AlSaqr-platform/he-soc/hardware/regressions/regression.csv

0 | ../software/iommu/iommu_test_01_04.elf | none | none |  | 0
0 | ../software/iommu/iommu_test_05.elf | none | none |  | 0
0 | ../software/iommu/iommu_test_06_10.elf | none | none |  | 0
0 | ../software/iommu/iommu_test_11_12.elf | none | none |  | 0
0 | ../software/snooper_test | opentitan/sw/tests/alsaqr/snooper_test/snooper_test_instr.elf | none |  | 0
0 | ../software/snooper_test | opentitan/sw/tests/alsaqr/snooper_test/snooper_test_addr.elf | none |  | 0
0 | ../software/snooper_test | opentitan/sw/tests/cluster/addressability/addressability.elf | none |  | 0
0 | ../software/peripherals/qspim_flash | none | none |  | 0
0 | ../software/peripherals/spim_flash | none | none |  | 0
0 | ../software/peripherals/uart | none | none |  | 0
0 | ../software/peripherals/usart | none | none |  | 0
0 | ../software/peripherals/sdio | none | none |  | 0
0 | ../software/peripherals/cam | none | none |  | 0
0 | ../software/peripherals/ethernet | none | none |  | 0
0 | ../software/can | none | none |  | 0
0 | ../software/hyperbus | none | none |  | 0
0 | ../software/l2_test_restricted | none | none |  | 0
0 | ../software/l3_test_4cs_2phy | none | none |  | 0
0 | ../software/llc_spm_test | none | none |  | 0
0 | ../software/hello_culsans | none | none |  | 0
0 | ../software/bypass_cva6_dco | none | none |  | 0
0 | ../software/pmu_IOPMP_L2RW_test | none | none |  | 0
0 | ../software/pmu_L3_test_v2 | none | none |  | 0
0 | ../software/pmu_test | none | none |  | 0
0 | ../software/monitor_counter | none | none |  | 0
0 | ../software/htm | none | none |  | 0
0 | ../software/mbox_test | opentitan/sw/tests/alsaqr/mbox_test/mbox_test.elf | none |  | 0
0 | ../software/hello_culsans | opentitan/sw/tests/opentitan/idma_test_advanced/bazel-out/idma_test.elf | none | 1 | 0
0 | ../software/hello_culsans | opentitan/sw/tests/cluster/mbox_test/mbox_test.elf | none | 1 | 0
0 | ../software/hello_culsans | opentitan/sw/tests/cluster/par_matmul_fp32/par_matmul_fp32.elf | none | 1 | 0
0 | ../software/hello_culsans | opentitan/sw/tests/opentitan/monitor_counter/bazel-out/monitor_counter.elf | none | 1 | 0
1 | ../software/hello_culsans | none | none | 1 | 0
