AlSaqr-platform/he-soc/hardware/regressions/regression_netlist.csv

0 | ../software/hello_culsans | none | none |  | 0
0 | ../software/hyperbus | none | none |  | 0
0 | ../software/l2_test_restricted | none | none |  | 0
0 | ../software/l3_test_4cs | none | none |  | 0
0 | ../software/llc_spm_test | none | none |  | 0
0 | ../software/mbox_test | opentitan/sw/tests/alsaqr/mbox_test/mbox_test.elf | none |  | 0
0 | ../software/hello_culsans | opentitan/sw/tests/cluster/mbox_test/mbox_test.elf | none | 1 | 0
0 | ../software/snooper_test | opentitan/sw/tests/cluster/addressability/addressability.elf | none |  | 0
0 | ../software/iommu/iommu_test_05.elf | none | none |  | 0
0 | ../software/hello_culsans | opentitan/sw/tests/opentitan/idma_test/idma_test.elf | none | 1 | 0
0 | ../software/hello_culsans | opentitan/sw/tests/cluster/par_matmul_fp32/par_matmul_fp32.elf | none | 1 | 0
