AlSaqr-platform/he-soc/software/gpios/gpios.c

/*
 * Copyright (C) 2021 ETH Zurich and University of Bologna
 *
 * Licensed under the Apache License, Version 2.0 (the "License");
 * you may not use this file except in compliance with the License.
 * You may obtain a copy of the License at
 *
 *     http://www.apache.org/licenses/LICENSE-2.0
 *
 * Unless required by applicable law or agreed to in writing, software
 * distributed under the License is distributed on an "AS IS" BASIS,
 * WITHOUT WARRANTIES OR CONDITIONS OF ANY KIND, either express or implied.
 * See the License for the specific language governing permissions and
 * limitations under the License.
 */

/*
 * Mantainer: Victor Isachi (victor.isachi@unibo.it)
 */

#include <stdio.h>
#include <stdint.h>
#include "utils.h"
#include "gpio_v3.h"
#include "udma.h"

#define BUFFER_SIZE 32

#define ARCHI_GPIO_ADDR 0x1A105000
#define CSR_MTOPEI 0x35C

#define OUT 1
#define IN  0

// #define FPGA_EMULATION
// #define SIMPLE_PAD

#ifndef FPGA_EMULATION
  #ifndef SIMPLE_PAD
    #define NUM_GPIOS_A 30
    #define NUM_GPIOS_B 48
    #define NUM_REPS 2
  #else
    #define NUM_GPIOS_A 0
    #define NUM_GPIOS_B 14
    #define NUM_REPS 1
  #endif
#else
  #define NUM_GPIOS_A 0
  #define NUM_GPIOS_B 14
  #define NUM_REPS 1
#endif

#define VERBOSE 1

uint32_t irq_configure(uint32_t number, uint32_t irq_en){
  uint32_t address;
  uint32_t gpio_inten;
  uint32_t gpio_inttype;

  if(number < 32){
    // Interrupt Enable Register for GPIO 0-31
    address = ARCHI_GPIO_ADDR + GPIO_INTEN_OFFSET;
    gpio_inten = pulp_read32(address);
    if(irq_en) {
      gpio_inten |= (1 << number);
    } else {
        gpio_inten &= ~(1 << number);
    }
    pulp_write32(address, gpio_inten);

    // Interrupt Type Register for GPIO 0-15 or 16-31
    if (number < 16) {
        address = ARCHI_GPIO_ADDR + GPIO_INTTYPE0_OFFSET;
        gpio_inttype = pulp_read32(address);
        // Set interrupt type to both edges (0x2)
        gpio_inttype |= (0x2 << (number * 2));
    } else {
        address = ARCHI_GPIO_ADDR + GPIO_INTTYPE1_OFFSET;
        gpio_inttype = pulp_read32(address);
        // Set interrupt type to both edges (0x2)
        gpio_inttype |= (0x2 << ((number-16)* 2));
    }
    pulp_write32(address, gpio_inttype);
  } else {
      // Interrupt Enable Register for GPIO 32-63
      address = ARCHI_GPIO_ADDR + GPIO_INTEN_32_63_OFFSET;
      gpio_inten = pulp_read32(address);

      if (irq_en) {
          gpio_inten |= (1 << (number - 32));
      } else {
          gpio_inten &= ~(1 << (number - 32));
      }
      pulp_write32(address, gpio_inten);

      // Interrupt Type Register for GPIO 0-15 or 16-31
      if (number < 48) {
          address = ARCHI_GPIO_ADDR + GPIO_INTTYPE_32_47_OFFSET;
          gpio_inttype = pulp_read32(address);
          // Set interrupt type to both edges (0x2)
          gpio_inttype |= (0x2 << ((number-32) * 2));
      } else {
          address = ARCHI_GPIO_ADDR + GPIO_INTTYPE_48_63_OFFSET;
          gpio_inttype = pulp_read32(address);
          // Set interrupt type to both edges (0x2)
          gpio_inttype |= (0x2 << ((number-48)* 2));
      }
      pulp_write32(address, gpio_inttype);
  }
  return 0;
}

// function to read the INTSTATUS register. interrupt is cleared when the status reg is read
uint32_t read_gpio_intstatus(uint32_t number) {
  uint32_t address;
  uint32_t status;

  if (number < 32) {
      address = ARCHI_GPIO_ADDR + GPIO_INTSTATUS_OFFSET;
      status = pulp_read32(address);
  } else {
      address = ARCHI_GPIO_ADDR + GPIO_INTSTATUS_32_63_OFFSET;
      status = pulp_read32(address);
  }

  return status;
}

uint32_t configure_gpio(uint32_t number, uint32_t direction){
  uint32_t address;
  uint32_t dir;
  uint32_t gpioen;
  //--- set GPIO
  if(number < 32){
    if (direction == IN) {
      address = ARCHI_GPIO_ADDR + GPIO_GPIOEN_OFFSET;
      gpioen = pulp_read32(address);
      //--- enable GPIO
      //printf("GPIOEN RD: %x\n",gpioen);
      gpioen |= (1 << number);
      //printf("GPIOEN WR: %x\n",gpioen);
      pulp_write32(address, gpioen);
      //--- set direction
      address = ARCHI_GPIO_ADDR + GPIO_PADDIR_OFFSET;
      dir = pulp_read32(address);
      //printf("GPIODIR RD: %x\n",dir);
      dir &= ~(1 << number);
      //printf("GPIODIR WR: %x\n",dir);
      pulp_write32(address, dir);
    }else if (direction == OUT){
      address = ARCHI_GPIO_ADDR + GPIO_GPIOEN_OFFSET;
      gpioen = pulp_read32(address);
      //--- enable GPIO
      //printf("GPIOEN RD: %x\n",gpioen);
      gpioen |= (1 << number);
      //printf("GPIOEN WR: %x\n",gpioen);
      pulp_write32(address, gpioen);
      //--- set direction
      address = ARCHI_GPIO_ADDR + GPIO_PADDIR_OFFSET;
      dir = pulp_read32(address);
      //printf("GPIODIR RD: %x\n",dir);
      dir |= (1 << number);
      //printf("GPIODIR WR: %x\n",dir);
      pulp_write32(address, dir);
    }
  }else{
    if (direction == IN){
      address = ARCHI_GPIO_ADDR + GPIO_GPIOEN_32_63_OFFSET;
      gpioen = pulp_read32(address);
      //--- enable GPIO
      //printf("GPIOEN RD: %x\n",gpioen);
      gpioen |= (1 << (number-32));
      //printf("GPIOEN WR: %x\n",gpioen);
      pulp_write32(address, gpioen);
      //--- set direction
      address = ARCHI_GPIO_ADDR + GPIO_PADDIR_32_63_OFFSET;
      dir = pulp_read32(address);
      //printf("GPIODIR RD: %x\n",dir);
      dir &= ~(1 << (number-32));
      //printf("GPIODIR WR: %x\n",dir);
      pulp_write32(address, dir);
    }else if (direction == OUT){
      address = ARCHI_GPIO_ADDR + GPIO_GPIOEN_32_63_OFFSET;
      gpioen = pulp_read32(address);
      //--- enable GPIO
      //printf("GPIOEN RD: %x\n",gpioen);
      gpioen |= (1 << (number-32));
      //printf("GPIOEN WR: %x\n",gpioen);
      pulp_write32(address, gpioen);
      //--- set direction
      address = ARCHI_GPIO_ADDR + GPIO_PADDIR_32_63_OFFSET;
      dir = pulp_read32(address);
      //printf("GPIODIR RD: %x\n",dir);
      dir |= (1 << (number-32));
      //printf("GPIODIR WR: %x\n",dir);
      pulp_write32(address, dir);
    }
  }

  while(pulp_read32(address) != dir);
}

void set_gpio(uint32_t number, uint32_t value){
  uint32_t value_wr;
  uint32_t address;
  if (number < 32){
    address = ARCHI_GPIO_ADDR + GPIO_PADOUT_OFFSET;
    value_wr = pulp_read32(address);
    if (value == 1){
      value_wr |= (1 << (number));
    }else{
      value_wr &= ~(1 << (number));
    }
    pulp_write32(address, value_wr);
  }else{
    address = ARCHI_GPIO_ADDR + GPIO_PADOUT_32_63_OFFSET;
    value_wr = pulp_read32(address);
    if (value == 1){
      value_wr |= (1 << (number % 32));
    }else{
      value_wr &= ~(1 << (number % 32));
    }
    pulp_write32(address, value_wr);
  }

  while(pulp_read32(address) != value_wr);
}

uint32_t get_gpio(uint32_t number){
  uint32_t value_rd;
  uint32_t address;
  uint32_t bit;
  if (number < 32){
    address = ARCHI_GPIO_ADDR + GPIO_PADIN_OFFSET;
    value_rd = pulp_read32(address);
    bit= 0x1 & (value_rd>>number);
  }else{
    address = ARCHI_GPIO_ADDR + GPIO_PADIN_32_63_OFFSET;
    value_rd = pulp_read32(address);
    bit= 0x1 & (value_rd>>(number%32));
  }
  //printf("GPIO %d: HEX:%x Bit:%d \n",number,value_rd,bit);
  return bit;
}

int main() {

  #ifdef FPGA_EMULATION
  int baud_rate = 115200;
  int test_freq = 50000000;
  #else
  set_flls();
  int baud_rate = 115200;
  int test_freq = 100000000;
  #endif
  uart_set_cfg(0,(test_freq/baud_rate)>>4);

  uint32_t error;
  uint32_t gpio_val;
  uint32_t address;

  uint32_t gpio_plic_id ;
  uint32_t gpio_imsic_id;



  error=0;

  for (int v = 0; v < NUM_REPS; v++){
    #ifdef FPGA_EMULATION
      alsaqr_periph_fpga_padframe_periphs_pad_gpio_b_00_mux_set( 1 );
      alsaqr_periph_fpga_padframe_periphs_pad_gpio_b_01_mux_set( 1 );
      alsaqr_periph_fpga_padframe_periphs_pad_gpio_b_02_mux_set( 1 );
      alsaqr_periph_fpga_padframe_periphs_pad_gpio_b_03_mux_set( 1 );
      alsaqr_periph_fpga_padframe_periphs_pad_gpio_b_04_mux_set( 1 );
      alsaqr_periph_fpga_padframe_periphs_pad_gpio_b_05_mux_set( 1 );
      alsaqr_periph_fpga_padframe_periphs_pad_gpio_b_06_mux_set( 1 );
      alsaqr_periph_fpga_padframe_periphs_pad_gpio_b_07_mux_set( 1 );
      alsaqr_periph_fpga_padframe_periphs_pad_gpio_b_08_mux_set( 1 );
      alsaqr_periph_fpga_padframe_periphs_pad_gpio_b_09_mux_set( 1 );
      alsaqr_periph_fpga_padframe_periphs_pad_gpio_b_10_mux_set( 1 );
      alsaqr_periph_fpga_padframe_periphs_pad_gpio_b_11_mux_set( 1 );
      alsaqr_periph_fpga_padframe_periphs_pad_gpio_b_12_mux_set( 1 );
      alsaqr_periph_fpga_padframe_periphs_pad_gpio_b_13_mux_set( 1 );
    #else
      #ifdef SIMPLE_PAD
        alsaqr_periph_fpga_padframe_periphs_pad_gpio_b_00_mux_set( 1 );
        alsaqr_periph_fpga_padframe_periphs_pad_gpio_b_01_mux_set( 1 );
        alsaqr_periph_fpga_padframe_periphs_pad_gpio_b_02_mux_set( 1 );
        alsaqr_periph_fpga_padframe_periphs_pad_gpio_b_03_mux_set( 1 );
        alsaqr_periph_fpga_padframe_periphs_pad_gpio_b_04_mux_set( 1 );
        alsaqr_periph_fpga_padframe_periphs_pad_gpio_b_05_mux_set( 1 );
        alsaqr_periph_fpga_padframe_periphs_pad_gpio_b_06_mux_set( 1 );
        alsaqr_periph_fpga_padframe_periphs_pad_gpio_b_07_mux_set( 1 );
        alsaqr_periph_fpga_padframe_periphs_pad_gpio_b_08_mux_set( 1 );
        alsaqr_periph_fpga_padframe_periphs_pad_gpio_b_09_mux_set( 1 );
        alsaqr_periph_fpga_padframe_periphs_pad_gpio_b_10_mux_set( 1 );
        alsaqr_periph_fpga_padframe_periphs_pad_gpio_b_11_mux_set( 1 );
        alsaqr_periph_fpga_padframe_periphs_pad_gpio_b_12_mux_set( 1 );
        alsaqr_periph_fpga_padframe_periphs_pad_gpio_b_13_mux_set( 1 );
      #else
        switch(v){
          // pad_a GPIOs
          case 0:
            alsaqr_periph_padframe_periphs_a_00_mux_set(2);
            alsaqr_periph_padframe_periphs_a_01_mux_set(2);
            alsaqr_periph_padframe_periphs_a_02_mux_set(2);
            alsaqr_periph_padframe_periphs_a_03_mux_set(2);
            alsaqr_periph_padframe_periphs_a_04_mux_set(2);
            alsaqr_periph_padframe_periphs_a_05_mux_set(1);
            alsaqr_periph_padframe_periphs_a_06_mux_set(1);
            alsaqr_periph_padframe_periphs_a_07_mux_set(1);
            alsaqr_periph_padframe_periphs_a_08_mux_set(1);
            alsaqr_periph_padframe_periphs_a_09_mux_set(1);
            alsaqr_periph_padframe_periphs_a_10_mux_set(1);
            alsaqr_periph_padframe_periphs_a_11_mux_set(1);
            alsaqr_periph_padframe_periphs_a_12_mux_set(1);
            alsaqr_periph_padframe_periphs_a_13_mux_set(1);
            alsaqr_periph_padframe_periphs_a_14_mux_set(1);
            alsaqr_periph_padframe_periphs_a_15_mux_set(2);
            alsaqr_periph_padframe_periphs_a_16_mux_set(2);
            alsaqr_periph_padframe_periphs_a_17_mux_set(2);
            alsaqr_periph_padframe_periphs_a_18_mux_set(3);
            alsaqr_periph_padframe_periphs_a_19_mux_set(3);
            alsaqr_periph_padframe_periphs_a_20_mux_set(3);
            alsaqr_periph_padframe_periphs_a_21_mux_set(3);
            alsaqr_periph_padframe_periphs_a_22_mux_set(3);
            alsaqr_periph_padframe_periphs_a_23_mux_set(3);
            alsaqr_periph_padframe_periphs_a_24_mux_set(3);
            alsaqr_periph_padframe_periphs_a_25_mux_set(3);
            alsaqr_periph_padframe_periphs_a_26_mux_set(3);
            alsaqr_periph_padframe_periphs_a_27_mux_set(3);
            alsaqr_periph_padframe_periphs_a_28_mux_set(3);
            alsaqr_periph_padframe_periphs_a_29_mux_set(3);

            alsaqr_periph_padframe_periphs_b_00_mux_set(0);
            alsaqr_periph_padframe_periphs_b_01_mux_set(0);
            alsaqr_periph_padframe_periphs_b_02_mux_set(0);
            alsaqr_periph_padframe_periphs_b_03_mux_set(0);
            alsaqr_periph_padframe_periphs_b_04_mux_set(0);
            alsaqr_periph_padframe_periphs_b_05_mux_set(0);
            alsaqr_periph_padframe_periphs_b_06_mux_set(0);
            alsaqr_periph_padframe_periphs_b_07_mux_set(0);
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
            alsaqr_periph_padframe_periphs_b_44_mux_set(2);
            alsaqr_periph_padframe_periphs_b_45_mux_set(2);
            alsaqr_periph_padframe_periphs_b_46_mux_set(2);
            alsaqr_periph_padframe_periphs_b_47_mux_set(2);
            break;
        }
      #endif
    #endif

    uint32_t gpio_a_irq_id = 179;
    uint32_t gpio_b_irq_id = 188;
    uint32_t gpio_a_imsic_id = 1;
    uint32_t gpio_b_imsic_id = 2;

    switch(v){
      // pad_a GPIOs
      case 0:
        aplic_init();
        imsic_init();
        config_irq_aplic(gpio_a_irq_id, gpio_a_imsic_id, 0);
        for(int i = 0; i < NUM_GPIOS_A/2; i++) {
          configure_gpio( i , OUT );
          #if VERBOSE > 1
            printf("gpio_a_%0d direction: %s\n", i, "OUT");
          #endif
        }
        for(int i = NUM_GPIOS_A/2; i < NUM_GPIOS_A; i++) {
          configure_gpio( i , IN );
          #if VERBOSE > 1
            printf("gpio_a_%0d direction: %s\n", i, "IN");
          #endif
        }
        irq_configure(15, 1);
        printf("Start pad_a GPIOs...\n");

        gpio_val=1;
        for (int j = 0; j < 10; j++){
          for(int i = 0; i < NUM_GPIOS_A/2; i++) {
            set_gpio( i , gpio_val);
            #if VERBOSE > 5
              printf("gpio_a_%0d value: %0d\n", i, gpio_val);
            #endif
          }
          for(int i = NUM_GPIOS_A/2; i < NUM_GPIOS_A; i++) {
            if(i==15) {
              asm volatile ("wfi");
              imsic_intp_arrive(gpio_a_imsic_id);
              read_gpio_intstatus(15);
              CSRW(CSR_MTOPEI, 0);
              aplic_reset(gpio_a_imsic_id);
            }

            if(get_gpio(i) != gpio_val){
              printf("ERROR: gpio_a_%0d value != %0d\n", i, gpio_val);
              error++;
            }

          }
          gpio_val=!gpio_val;
        }
        break;



      // pad_b GPIOs
      case 1:
        aplic_init();
        imsic_init();
        config_irq_aplic(gpio_b_irq_id, gpio_b_imsic_id, 0);
        for(int i = 0; i < NUM_GPIOS_B/2; i++) {
          configure_gpio( i , OUT );
          #if VERBOSE > 1
            printf("gpio_b_%0d direction: %s\n", i, "OUT");
          #endif
        }
        for(int i = NUM_GPIOS_B/2; i < NUM_GPIOS_B; i++) {
          configure_gpio( i , IN );
          #if VERBOSE > 1
            printf("gpio_b_%0d direction: %s\n", i, "IN");
          #endif
        }
        irq_configure(24, 1);

        printf("Start pad_b GPIOs...\n");
        gpio_val=1;
        for (int j = 0; j < 10; j++){
          for(int i = 0; i < NUM_GPIOS_B/2; i++) {
            set_gpio( i , gpio_val);
            #if VERBOSE > 5
              printf("gpio_b_%0d value: %0d\n", i, gpio_val);
            #endif
          }

          for(int i = NUM_GPIOS_B/2; i < NUM_GPIOS_B; i++) {
            if(i==24) {
              asm volatile ("wfi");
              imsic_intp_arrive(gpio_b_imsic_id);
              read_gpio_intstatus(24);
              CSRW(CSR_MTOPEI, 0);
              aplic_reset(gpio_b_imsic_id);
            }

            if(get_gpio(i) != gpio_val){
              printf("ERROR: gpio_b_%0d value != %0d\n", i, gpio_val);
              error++;
            }
          }
          gpio_val=!gpio_val;
        }
        break;
    }
  }

  if(!error)
    printf("Test PASSED\n\r");
  else
    printf("Test FAILED\n\r");
  return error;
}
