AlSaqr-platform/he-soc/hardware/fpga/alsaqr/tcl/fmc_board_hyper_vcu118.xdc

####################################################################
# 							Hyper Bus 0                                        #
####################################################################

set_property -dict {PACKAGE_PIN AY9  IOSTANDARD LVCMOS18}  [get_ports FMC_hyper0_ck]
set_property -dict {PACKAGE_PIN BA9  IOSTANDARD LVCMOS18}  [get_ports FMC_hyper0_ckn]
set_property -dict {PACKAGE_PIN AW13 IOSTANDARD LVCMOS18}  [get_ports FMC_hyper0_csn0]
set_property -dict {PACKAGE_PIN AY13 IOSTANDARD LVCMOS18}  [get_ports FMC_hyper0_csn1]
set_property -dict {PACKAGE_PIN BC14 IOSTANDARD LVCMOS18}  [get_ports FMC_hyper0_rwds]
set_property -dict {PACKAGE_PIN AT12 IOSTANDARD LVCMOS18}  [get_ports FMC_hyper0_reset]
set_property -dict {PACKAGE_PIN BF15 IOSTANDARD LVCMOS18}  [get_ports FMC_hyper0_dqio0]
set_property -dict {PACKAGE_PIN BE15 IOSTANDARD LVCMOS18}  [get_ports FMC_hyper0_dqio1]
set_property -dict {PACKAGE_PIN BE12 IOSTANDARD LVCMOS18}  [get_ports FMC_hyper0_dqio2]
set_property -dict {PACKAGE_PIN BD12 IOSTANDARD LVCMOS18}  [get_ports FMC_hyper0_dqio3]
set_property -dict {PACKAGE_PIN AV9  IOSTANDARD LVCMOS18}  [get_ports FMC_hyper0_dqio4]
set_property -dict {PACKAGE_PIN AV8  IOSTANDARD LVCMOS18}  [get_ports FMC_hyper0_dqio5]
set_property -dict {PACKAGE_PIN AW11 IOSTANDARD LVCMOS18}  [get_ports FMC_hyper0_dqio6]
set_property -dict {PACKAGE_PIN AY10 IOSTANDARD LVCMOS18}  [get_ports FMC_hyper0_dqio7]

# G6
# G7
# G24
# G25
# G15
# G27
# G13
# G12
# G10
# G9
# G18
# G19
# G21
# G22

set_property -dict {PACKAGE_PIN AP12 IOSTANDARD LVCMOS18}  [get_ports FMC_hyper1_ck]
set_property -dict {PACKAGE_PIN AR12 IOSTANDARD LVCMOS18}  [get_ports FMC_hyper1_ckn]
set_property -dict {PACKAGE_PIN AP16 IOSTANDARD LVCMOS18}  [get_ports FMC_hyper1_csn0]
set_property -dict {PACKAGE_PIN AT14 IOSTANDARD LVCMOS18}  [get_ports FMC_hyper1_csn1]
set_property -dict {PACKAGE_PIN AL14 IOSTANDARD LVCMOS18}  [get_ports FMC_hyper1_rwds]
set_property -dict {PACKAGE_PIN AW7  IOSTANDARD LVCMOS18}  [get_ports FMC_hyper1_reset]
set_property -dict {PACKAGE_PIN BE14 IOSTANDARD LVCMOS18}  [get_ports FMC_hyper1_dqio0]
set_property -dict {PACKAGE_PIN BF14 IOSTANDARD LVCMOS18}  [get_ports FMC_hyper1_dqio1]
set_property -dict {PACKAGE_PIN BA14 IOSTANDARD LVCMOS18}  [get_ports FMC_hyper1_dqio2]
set_property -dict {PACKAGE_PIN BB14 IOSTANDARD LVCMOS18}  [get_ports FMC_hyper1_dqio3]
set_property -dict {PACKAGE_PIN BD13 IOSTANDARD LVCMOS18}  [get_ports FMC_hyper1_dqio4]
set_property -dict {PACKAGE_PIN BE13 IOSTANDARD LVCMOS18}  [get_ports FMC_hyper1_dqio5]
set_property -dict {PACKAGE_PIN BB13 IOSTANDARD LVCMOS18}  [get_ports FMC_hyper1_dqio6]
set_property -dict {PACKAGE_PIN BB12 IOSTANDARD LVCMOS18}  [get_ports FMC_hyper1_dqio7]

# C22
# C23
# D24
# D21
# C26
# C19
# D11
# D12
# D14
# D15
# C10
# C11
# C14
# C15
