AlSaqr-platform/he-soc/hardware/tb/ariane_tb.sv

// Copyright 2023 ETH Zurich and University of Bologna.
// Copyright and related rights are licensed under the Solderpad Hardware
// License, Version 0.51 (the "License"); you may not use this file except in
// compliance with the License.  You may obtain a copy of the License at
// http://solderpad.org/licenses/SHL-0.51. Unless required by applicable law
// or agreed to in writing, software, hardware and materials distributed under
// this License is distributed on an "AS IS" BASIS, WITHOUT WARRANTIES OR
// CONDITIONS OF ANY KIND, either express or implied. See the License for the
// specific language governing permissions and limitations under the License.
//
// Author: Luca Valente, University of Bologna
// Author: Mattia Sinigaglia, University of Bologna
// Date: 13/07/2023
// Description: Top level testbench module. Instantiates the top level DUT, configures
//              the virtual interfaces and starts the test passed by +UVM_TEST+
//`define TEST_CLOCK_BYPASS

`timescale 1ps/1ps

import ariane_pkg::*;
import uvm_pkg::*;
import ariane_soc::*;
import jtag_ot_pkg::*;
import snooper_pkg::*;
import ariane_soc::HyperbusNumPhys;
import ariane_soc::NumChipsPerHyperbus;
import pkg_internal_alsaqr_periph_padframe_periphs::*;
import pkg_internal_alsaqr_periph_fpga_padframe_periphs::*;

`include "uvm_macros.svh"
`include "axi/assign.svh"
`include "axi/typedef.svh"
`include "register_interface/typedef.svh"
`include "register_interface/assign.svh"

//`define POWER_PROFILE
//`define POWER_CVA6
`define PAD_MUX_REG_PATH dut.i_alsaqr_periph_padframe.i_periphs.i_periphs_muxer.s_reg2hw
`define SIMPLE_PAD_MUX_REG_PATH dut.i_alsaqr_periph_fpga_padframe.i_periphs.i_periphs_muxer.s_reg2hw
//`define TEST_SNOOPER

import "DPI-C" function byte read_elf(input string filename);
import "DPI-C" function byte get_entry(output longint entry);
import "DPI-C" function byte get_section(output longint address, output longint len);
import "DPI-C" context function byte read_section(input longint address, inout byte buffer[], input longint len);


module ariane_tb;

  static uvm_cmdline_processor uvcl = uvm_cmdline_processor::get_inst();

  localparam int unsigned REFClockPeriod       = 1us;
  localparam int unsigned REFClockPeriodOt     = 25ns;

  `ifdef ETH2FMC_NO_PADFRAME
    localparam int unsigned REFClockPeriod200     = 5ns; // eth200 clock: 200MHz
    localparam int unsigned REFClockPeriod125     = 8ns; // eth125 clock: 125MHz
  `endif

  // toggle with RTC period
  `ifndef TEST_CLOCK_BYPASS
    localparam int unsigned RTC_CLOCK_PERIOD = 30.517us;
  `else
    localparam int unsigned RTC_CLOCK_PERIOD = 2ns;
  `endif

  localparam NUM_WORDS = 2**25;
  logic clk_i;
  logic rst_ni;
  logic rtc_i;
  logic s_rst_ni;
  logic s_rtc_i;
  logic s_bypass;
  logic s_eth_clk125_0;
  logic s_eth_clk125_90;
  logic s_eth_clk200;
  logic s_eth_rstni;

  localparam NumPhys = ariane_soc::HyperbusNumPhys;
  localparam NumChips = ariane_soc::NumChipsPerHyperbus;
 
  localparam ENABLE_DM_TESTS = 0;

  parameter  USE_HYPER_MODELS     = 1;
  parameter  USE_24FC1025_MODEL   = 1;
  parameter  USE_S25FS256S_MODEL  = 1;
  parameter  USE_UART             = 1;
  parameter  USE_USART            = 1;
  parameter  USE_SDVT_CPI         = 1;
  parameter  USE_SDIO             = 1;
  parameter  USE_CAN              = 1;
  parameter  USE_ETHERNET         = 1;

  parameter DW       = ariane_axi_soc::DataWidth;
  parameter AW       = ariane_axi_soc::AddrWidth;
  parameter UW       = ariane_axi_soc::UserWidth;
  parameter IW       = ariane_soc::IdWidth;

  AXI_BUS_DV#(
    .AXI_ADDR_WIDTH(AW),
    .AXI_DATA_WIDTH(DW),
    .AXI_ID_WIDTH(IW),
    .AXI_USER_WIDTH(UW)
  )axi_master_dv(clk_i);

  AXI_BUS#(
    .AXI_ADDR_WIDTH(AW),
    .AXI_DATA_WIDTH(DW),
    .AXI_ID_WIDTH(IW),
    .AXI_USER_WIDTH(UW)
  )axi_master();

  `AXI_ASSIGN(axi_master, axi_master_dv)

  typedef axi_test::axi_driver #(.AW(AW), .DW(DW), .IW(IW), .UW(UW), .TA(200ps), .TT(700ps)) axi_drv_t;
  axi_drv_t axi_master_drv =  new(axi_master_dv);

  typedef logic [AW-1:0]   axi_addr_t;
  typedef logic [DW-1:0]   axi_data_t;
  typedef logic [DW/8-1:0] axi_strb_t;
  typedef logic [IW-1:0]   axi_id_t;

  //beats
  axi_test::axi_ax_beat #(.AW(AW), .IW(IW), .UW(UW)) ar_beat = new();
  axi_test::axi_r_beat  #(.DW(DW), .IW(IW), .UW(UW)) r_beat  = new();
  axi_test::axi_ax_beat #(.AW(AW), .IW(IW), .UW(UW)) aw_beat = new();
  axi_test::axi_w_beat  #(.DW(DW), .UW(UW))          w_beat  = new();
  axi_test::axi_b_beat  #(.IW(IW), .UW(UW))          b_beat  = new();

  task reset_master;
    input axi_drv_t axi_master_drv;
    axi_master_drv.reset_master();
  endtask

  task read_axi;
    input axi_drv_t axi_master_drv;
    input axi_addr_t raddr;

    ar_beat.ax_addr  = raddr;
    axi_master_drv.send_ar(ar_beat);
    axi_master_drv.recv_r(r_beat);
    $display("Read data: %x", r_beat.r_data);
  endtask // read_axi
 
  task write_axi;
    input axi_drv_t axi_master_drv;    
    input axi_addr_t waddr;
    input axi_data_t wdata;
    input axi_strb_t wstrb;

    aw_beat.ax_addr  = waddr;
    w_beat.w_strb    = wstrb;
    w_beat.w_last    = 1'b1;
    w_beat.w_data    = wdata;

    axi_master_drv.send_aw(aw_beat);
    axi_master_drv.send_w(w_beat);
    $display("Written data: %x", w_beat.w_data);
    axi_master_drv.recv_b(b_beat);
    
  endtask; // write_axi

  ////////////////////////////////
  //                            //
  //  LINKER SCRIPT PARAMETERS  //
  //                            //
  ////////////////////////////////
 `ifdef NO_L3_CONNECTION
  parameter  LINKER_ENTRY        = 32'h1C000000;
  parameter  TOHOST              = 32'h1C000100;
 `else
  // when preload is enabled LINKER_ENTRY specifies the linker address which must be L3 -> 32'h80000000
  parameter  LINKER_ENTRY        = 32'h80000000;
  // IMPORTANT : If you change the linkerscript check the tohost address and update this paramater
  // IMPORTANT : to host mapped in L2 non-cached region because we use WB cache
  `ifndef CODE_IN_L2
  parameter  TOHOST              = 32'h1c000000;
  `else
   parameter TOHOST              = 32'h1c000100;
  `endif

 `endif

  `ifdef USE_LOCAL_JTAG
    parameter  PRELOAD_HYPERRAM = 0;
  `else
    parameter  PRELOAD_HYPERRAM = 1;
  `endif

  `ifdef POSTLAYOUT
    localparam int unsigned JtagSampleDelay = (REFClockPeriod < 10ns) ? 2 : 1;
  `else
    localparam int unsigned JtagSampleDelay = 0;
  `endif

  `ifdef SIM_JTAG
    parameter int   sim_jtag_enable = '1 ;
  `else
    parameter int   sim_jtag_enable = '0 ;
  `endif

    localparam logic [15:0] PartNumber = 1;
    logic program_loaded = 0;
    logic  eoc;
    logic [31:0]  retval = 32'h0;  // Store return value

    localparam AxiWideBeWidth    = ariane_axi_soc::DataWidth / 8;
    localparam AxiWideByteOffset = $clog2(AxiWideBeWidth);
    localparam AxiWideBeWidth_ib    = 4;
    localparam AxiWideByteOffset_ib = $clog2(AxiWideBeWidth_ib);
    typedef logic [ariane_axi_soc::AddrWidth-1:0] addr_t;
    typedef logic [ariane_axi_soc::DataWidth-1:0] data_t;
    data_t memory [bit [31:0]];
    int sections  [bit [31:0]];

    logic [31:0] ibex_memory [bit [31:0]];
    int   ibex_sections [bit [31:0]];

    wire                  s_jtag_TCK       ;
    wire                  s_jtag_TMS       ;
    wire                  s_jtag_TDI       ;
    wire                  s_jtag_TRSTn     ;
    wire                  s_jtag_TDO_data  ;
    wire                  s_jtag_TDO_driven;

    string                stimuli_file      ;
    logic                 s_tck         ;
    logic                 s_ot_tck      ;
    logic                 s_tms         ;
    logic                 s_tdi         ;
    logic                 s_trstn       ;
    logic                 s_tdo         ;

    wire                  s_jtag_to_alsaqr_tck       ;
    wire                  s_jtag_to_alsaqr_tms       ;
    wire                  s_jtag_to_alsaqr_tdi       ;
    wire                  s_jtag_to_alsaqr_trstn     ;
    wire                  s_jtag_to_alsaqr_tdo       ;

    wire  [NumPhys-1:0][NumChips-1:0] hyper_cs_n_wire;
    wire  [NumPhys-1:0]      hyper_ck_wire;
    wire  [NumPhys-1:0]      hyper_ck_n_wire;
    wire  [NumPhys-1:0]      hyper_rwds_wire;
    wire  [NumPhys-1:0][7:0] hyper_dq_wire;
    wire  [NumPhys-1:0]      hyper_reset_n_wire;

    wire                  soc_clock;

    trace_t traces;

    `ifdef ETH2FMC_NO_PADFRAME
      logic               s_tck200;
      logic               s_tck125_0;
      logic               s_tck125_90;
      wire                s_core_eth_rstn;
      wire                s_core_eth_rxck;
      wire                s_core_eth_rxctl;
      wire [3:0]          s_core_eth_rxd;
      wire                s_core_eth_txck;
      wire                s_core_eth_txctl;
      wire [3:0]          s_core_eth_txd;
      wire                s_core_eth_mdio;
      wire                s_core_eth_mdc;
    `endif

    wire                  w_i2c_sda      ;
    wire                  w_i2c_scl      ;

    tri                   w_spim_sck     ;
    tri                   w_spim_csn0    ;
    tri                   w_spim_sdio0   ;
    wire                  w_spim_sdio1   ;
    tri                   w_spim_sdio2   ;
    tri                   w_spim_sdio3   ;

    wire                  w_cam_pclk;   //is his even needed???
    wire [7:0]            w_cam_0_data;
    wire [7:0]            w_cam_1_data;
    wire                  w_cam_hsync;  //is his even needed???
    wire                  w_cam_vsync;  //is his even needed???

    wire [3:0]            w_eth_tx0_data;
    wire [3:0]            w_eth_rx0_data;

    wire [3:0]            w_eth_tx2_data;
    wire [3:0]            w_eth_rx2_data;

    logic                 s_ot_tms         ;
    logic                 s_ot_tdi         ;
    logic                 s_ot_trstn       ;
    logic                 s_ot_tdo         ;

    wire                  s_jtag2ot_tck    ;
    wire                  s_jtag2ot_tms    ;
    wire                  s_jtag2ot_tdi    ;
    wire                  s_jtag2ot_trstn  ;
    wire                  s_jtag2ot_tdo    ;

    logic                 bootmode;
    logic                 boot_mode;

    logic                  trace_mode_instruction;
    wire    pad_periphs_a_00_pad;
    wire    pad_periphs_a_01_pad;
    wire    pad_periphs_a_02_pad;
    wire    pad_periphs_a_03_pad;
    wire    pad_periphs_a_04_pad;
    wire    pad_periphs_a_05_pad;
    wire    pad_periphs_a_06_pad;
    wire    pad_periphs_a_07_pad;
    wire    pad_periphs_a_08_pad;
    wire    pad_periphs_a_09_pad;
    wire    pad_periphs_a_10_pad;
    wire    pad_periphs_a_11_pad;
    wire    pad_periphs_a_12_pad;
    wire    pad_periphs_a_13_pad;
    wire    pad_periphs_a_14_pad;
    wire    pad_periphs_a_15_pad;
    wire    pad_periphs_a_16_pad;
    wire    pad_periphs_a_17_pad;
    wire    pad_periphs_a_18_pad;
    wire    pad_periphs_a_19_pad;
    wire    pad_periphs_a_20_pad;
    wire    pad_periphs_a_21_pad;
    wire    pad_periphs_a_22_pad;
    wire    pad_periphs_a_23_pad;
    wire    pad_periphs_a_24_pad;
    wire    pad_periphs_a_25_pad;
    wire    pad_periphs_a_26_pad;
    wire    pad_periphs_a_27_pad;
    wire    pad_periphs_a_28_pad;
    wire    pad_periphs_a_29_pad;

    wire    pad_periphs_b_00_pad;
    wire    pad_periphs_b_01_pad;
    wire    pad_periphs_b_02_pad;
    wire    pad_periphs_b_03_pad;
    wire    pad_periphs_b_04_pad;
    wire    pad_periphs_b_05_pad;
    wire    pad_periphs_b_06_pad;
    wire    pad_periphs_b_07_pad;
    wire    pad_periphs_b_08_pad;
    wire    pad_periphs_b_09_pad;
    wire    pad_periphs_b_10_pad;
    wire    pad_periphs_b_11_pad;
    wire    pad_periphs_b_12_pad;
    wire    pad_periphs_b_13_pad;
    wire    pad_periphs_b_14_pad;
    wire    pad_periphs_b_15_pad;
    wire    pad_periphs_b_16_pad;
    wire    pad_periphs_b_17_pad;
    wire    pad_periphs_b_18_pad;
    wire    pad_periphs_b_19_pad;
    wire    pad_periphs_b_20_pad;
    wire    pad_periphs_b_21_pad;
    wire    pad_periphs_b_22_pad;
    wire    pad_periphs_b_23_pad;
    wire    pad_periphs_b_24_pad;
    wire    pad_periphs_b_25_pad;
    wire    pad_periphs_b_26_pad;
    wire    pad_periphs_b_27_pad;
    wire    pad_periphs_b_28_pad;
    wire    pad_periphs_b_29_pad;
    wire    pad_periphs_b_30_pad;
    wire    pad_periphs_b_31_pad;
    wire    pad_periphs_b_32_pad;
    wire    pad_periphs_b_33_pad;
    wire    pad_periphs_b_34_pad;
    wire    pad_periphs_b_35_pad;
    wire    pad_periphs_b_36_pad;
    wire    pad_periphs_b_37_pad;
    wire    pad_periphs_b_38_pad;
    wire    pad_periphs_b_39_pad;
    wire    pad_periphs_b_40_pad;
    wire    pad_periphs_b_41_pad;
    wire    pad_periphs_b_42_pad;
    wire    pad_periphs_b_43_pad;
    wire    pad_periphs_b_44_pad;
    wire    pad_periphs_b_45_pad;
    wire    pad_periphs_b_46_pad;
    wire    pad_periphs_b_47_pad;

    wire    pad_periphs_ot_spi_00_pad;
    wire    pad_periphs_ot_spi_01_pad;
    wire    pad_periphs_ot_spi_02_pad;
    wire    pad_periphs_ot_spi_03_pad;

    wire                  w_cva6_uart_rx ;
    wire                  w_cva6_uart_tx ;
    wire                  apb_uart_rx ;
    wire                  apb_uart_tx ;

    wire ddr_ext_clk;

    longint unsigned cycles;
    longint unsigned max_cycles;

    logic [31:0] exit_o;
    bit [31:0]  exit_code;

    string        binary ;
    string        cluster_binary;
    string        ot_sram;
    string        ot_cluster;
    string        ot_flash;

    logic         cid;

    //**************************************************
    // PAD VIPs SIGNALS BEGINNING
    //**************************************************
    wire    alt_0_pad_periphs_a_00_pad_CORE_UART_TX    ;
    wire    alt_0_pad_periphs_a_01_pad_CORE_UART_RX    ;
    wire    alt_0_pad_periphs_a_02_pad_SDIO0_D1        ;
    wire    alt_0_pad_periphs_a_03_pad_SDIO0_D2        ;
    wire    alt_0_pad_periphs_a_04_pad_SDIO0_D3        ;
    wire    alt_0_pad_periphs_a_05_pad_SDIO0_D4        ;
    wire    alt_0_pad_periphs_a_06_pad_SDIO0_CLK       ;
    wire    alt_0_pad_periphs_a_07_pad_SDIO0_CMD       ;
    wire    alt_0_pad_periphs_a_08_pad_PWM0_CHANNEL0   ;
    wire    alt_0_pad_periphs_a_09_pad_PWM1_CHANNEL0   ;
    wire    alt_0_pad_periphs_a_10_pad_PWM2_CHANNEL0   ;
    wire    alt_0_pad_periphs_a_11_pad_PWM3_CHANNEL0   ;
    wire    alt_0_pad_periphs_a_12_pad_BARO1_I2C0_SCL  ;
    wire    alt_0_pad_periphs_a_13_pad_BARO1_I2C0_SDA  ;
    wire    alt_0_pad_periphs_a_14_pad_IMU1_SPI0_SCK   ;
    wire    alt_0_pad_periphs_a_15_pad_IMU1_SPI0_CS    ;
    wire    alt_0_pad_periphs_a_16_pad_IMU1_SPI0_MISO  ;
    wire    alt_0_pad_periphs_a_17_pad_IMU1_SPI0_MOSI  ;
    wire    alt_0_pad_periphs_a_18_pad_FRAM_SPI2_SCK   ;
    wire    alt_0_pad_periphs_a_19_pad_FRAM_SPI2_CS    ;
    wire    alt_0_pad_periphs_a_20_pad_FRAM_SPI2_MISO  ;
    wire    alt_0_pad_periphs_a_21_pad_FRAM_SPI2_MOSI  ;
    wire    alt_0_pad_periphs_a_22_pad_ADIO1_SPI3_SCK  ;
    wire    alt_0_pad_periphs_a_23_pad_ADIO1_SPI3_CS   ;
    wire    alt_0_pad_periphs_a_24_pad_ADIO1_SPI3_MISO ;
    wire    alt_0_pad_periphs_a_25_pad_ADIO1_SPI3_MOSI ;
    wire    alt_0_pad_periphs_a_26_pad_GPS2_UART0_TX   ;
    wire    alt_0_pad_periphs_a_27_pad_GPS2_UART0_RX   ;
    wire    alt_0_pad_periphs_a_28_pad_GPS2_I2C1_SCL   ;
    wire    alt_0_pad_periphs_a_29_pad_GPS2_I2C1_SDA   ;
    wire    alt_1_pad_periphs_a_00_pad_CORE_UART_TX    ;
    wire    alt_1_pad_periphs_a_01_pad_CORE_UART_RX    ;
    wire    alt_1_pad_periphs_a_02_pad_LINUX_QSPI_SCK  ;
    wire    alt_1_pad_periphs_a_03_pad_LINUX_QSPI_CSN  ;
    wire    alt_1_pad_periphs_a_04_pad_LINUX_QSPI_IO0  ;
    wire    alt_1_pad_periphs_a_05_pad_LINUX_QSPI_IO1  ;
    wire    alt_1_pad_periphs_a_06_pad_LINUX_QSPI_IO2  ;
    wire    alt_1_pad_periphs_a_07_pad_LINUX_QSPI_IO3  ;
    wire    alt_1_pad_periphs_a_08_pad_BARO1_I2C0_SCL  ;
    wire    alt_1_pad_periphs_a_09_pad_BARO1_I2C0_SDA  ;
    wire    alt_1_pad_periphs_a_10_pad_PWM0_CHANNEL0   ;
    wire    alt_1_pad_periphs_a_11_pad_PWM1_CHANNEL0   ;
    wire    alt_1_pad_periphs_a_12_pad_PWM2_CHANNEL0   ;
    wire    alt_1_pad_periphs_a_13_pad_PWM3_CHANNEL0   ;
    wire    alt_1_pad_periphs_a_14_pad_GPS1_UART2_TX   ;
    wire    alt_1_pad_periphs_a_15_pad_GPS1_UART2_RX   ;
    wire    alt_1_pad_periphs_a_16_pad_GPS1_I2C5_SCL   ;
    wire    alt_1_pad_periphs_a_17_pad_GPS1_I2C5_SDA   ;
    wire    alt_1_pad_periphs_a_18_pad_CAM0_CPI0_CLK   ;
    wire    alt_1_pad_periphs_a_19_pad_CAM0_CPI0_VSYNC ;
    wire    alt_1_pad_periphs_a_20_pad_CAM0_CPI0_HSYNC ;
    wire    alt_1_pad_periphs_a_21_pad_CAM0_CPI0_DAT0  ;
    wire    alt_1_pad_periphs_a_22_pad_CAM0_CPI0_DAT1  ;
    wire    alt_1_pad_periphs_a_23_pad_CAM0_CPI0_DAT2  ;
    wire    alt_1_pad_periphs_a_24_pad_CAM0_CPI0_DAT3  ;
    wire    alt_1_pad_periphs_a_25_pad_CAM0_CPI0_DAT4  ;
    wire    alt_1_pad_periphs_a_26_pad_CAM0_CPI0_DAT5  ;
    wire    alt_1_pad_periphs_a_27_pad_CAM0_CPI0_DAT6  ;
    wire    alt_1_pad_periphs_a_28_pad_CAM0_CPI0_DAT7  ;
    wire    alt_1_pad_periphs_a_29_pad_FLL_SOC         ;
    wire    alt_2_pad_periphs_a_00_pad_CAN0_TX            ;
    wire    alt_2_pad_periphs_a_01_pad_CAN0_RX            ;
    wire    alt_2_pad_periphs_a_02_pad_CAN1_TX            ;
    wire    alt_2_pad_periphs_a_03_pad_CAN1_RX            ;
    wire    alt_2_pad_periphs_a_04_pad_FLL_SOC            ;
    wire    alt_2_pad_periphs_a_05_pad_IO_USART1_TX       ;
    wire    alt_2_pad_periphs_a_06_pad_IO_USART1_RX       ;
    wire    alt_2_pad_periphs_a_07_pad_IO_USART1_RTS      ;
    wire    alt_2_pad_periphs_a_08_pad_IO_USART1_CTS      ;
    wire    alt_2_pad_periphs_a_09_pad_WIRELESS_SDIO1_D0  ;
    wire    alt_2_pad_periphs_a_10_pad_WIRELESS_SDIO1_D1  ;
    wire    alt_2_pad_periphs_a_11_pad_WIRELESS_SDIO1_D2  ;
    wire    alt_2_pad_periphs_a_12_pad_WIRELESS_SDIO1_D3  ;
    wire    alt_2_pad_periphs_a_13_pad_WIRELESS_SDIO1_CLK ;
    wire    alt_2_pad_periphs_a_14_pad_WIRELESS_SDIO1_CMD ;
    wire    alt_2_pad_periphs_a_15_pad_ETH_RST            ;
    wire    alt_2_pad_periphs_a_16_pad_ETH_RXCK           ;
    wire    alt_2_pad_periphs_a_17_pad_ETH_RXCTL          ;
    wire    alt_2_pad_periphs_a_18_pad_ETH_RXD0           ;
    wire    alt_2_pad_periphs_a_19_pad_ETH_RXD1           ;
    wire    alt_2_pad_periphs_a_20_pad_ETH_RXD2           ;
    wire    alt_2_pad_periphs_a_21_pad_ETH_RXD3           ;
    wire    alt_2_pad_periphs_a_22_pad_ETH_TXCK           ;
    wire    alt_2_pad_periphs_a_23_pad_ETH_TXCTL          ;
    wire    alt_2_pad_periphs_a_24_pad_ETH_TXD0           ;
    wire    alt_2_pad_periphs_a_25_pad_ETH_TXD1           ;
    wire    alt_2_pad_periphs_a_26_pad_ETH_TXD2           ;
    wire    alt_2_pad_periphs_a_27_pad_ETH_TXD3           ;
    wire    alt_2_pad_periphs_a_28_pad_ETH_MDIO           ;
    wire    alt_2_pad_periphs_a_29_pad_ETH_MDC            ;
    wire    alt_3_pad_periphs_a_00_pad_IO_GPIO00 ;
    wire    alt_3_pad_periphs_a_01_pad_IO_GPIO01 ;
    wire    alt_3_pad_periphs_a_02_pad_IO_GPIO02 ;
    wire    alt_3_pad_periphs_a_03_pad_IO_GPIO03 ;
    wire    alt_3_pad_periphs_a_04_pad_IO_GPIO04 ;
    wire    alt_3_pad_periphs_a_05_pad_IO_GPIO05 ;
    wire    alt_3_pad_periphs_a_06_pad_IO_GPIO06 ;
    wire    alt_3_pad_periphs_a_07_pad_IO_GPIO07 ;
    wire    alt_3_pad_periphs_a_08_pad_IO_GPIO08 ;
    wire    alt_3_pad_periphs_a_09_pad_IO_GPIO09 ;
    wire    alt_3_pad_periphs_a_10_pad_IO_GPIO10 ;
    wire    alt_3_pad_periphs_a_11_pad_IO_GPIO11 ;
    wire    alt_3_pad_periphs_a_12_pad_IO_GPIO12 ;
    wire    alt_3_pad_periphs_a_13_pad_IO_GPIO13 ;
    wire    alt_3_pad_periphs_a_14_pad_IO_GPIO14 ;
    wire    alt_3_pad_periphs_a_15_pad_IO_GPIO15 ;
    wire    alt_3_pad_periphs_a_16_pad_IO_GPIO16 ;
    wire    alt_3_pad_periphs_a_17_pad_IO_GPIO17 ;
    wire    alt_3_pad_periphs_a_18_pad_IO_GPIO18 ;
    wire    alt_3_pad_periphs_a_19_pad_IO_GPIO19 ;
    wire    alt_3_pad_periphs_a_20_pad_IO_GPIO20 ;
    wire    alt_3_pad_periphs_a_21_pad_IO_GPIO21 ;
    wire    alt_3_pad_periphs_a_22_pad_IO_GPIO22 ;
    wire    alt_3_pad_periphs_a_23_pad_IO_GPIO23 ;
    wire    alt_3_pad_periphs_a_24_pad_IO_GPIO24 ;
    wire    alt_3_pad_periphs_a_25_pad_IO_GPIO25 ;
    wire    alt_3_pad_periphs_a_26_pad_IO_GPIO26 ;
    wire    alt_3_pad_periphs_a_27_pad_IO_GPIO27 ;
    wire    alt_3_pad_periphs_a_28_pad_IO_GPIO28 ;
    wire    alt_3_pad_periphs_a_29_pad_IO_GPIO29 ;
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
