AlSaqr-platform/he-soc/hardware/host/al_saqr.sv

// Copyright 2018 ETH Zurich and University of Bologna.
// Copyright and related rights are licensed under the Solderpad Hardware
// License, Version 0.51 (the "License"); you may not use this file except in
// compliance with the License.  You may obtain a copy of the License at
// http://solderpad.org/licenses/SHL-0.51. Unless required by applicable law
// or agreed to in writing, software, hardware and materials distributed under
// this License is distributed on an "AS IS" BASIS, WITHOUT WARRANTIES OR
// CONDITIONS OF ANY KIND, either express or implied. See the License for the
// specific language governing permissions and limitations under the License.
//
// Author: Luca Valente, University of Bologna
// Author: Mattia Sinigaglia, University of Bologna
// Date: 18.06.2021
// Description: AlSaqr platform, it holds host_domain and cluster
`define EXCLUDE_CLUSTER
`include "register_interface/typedef.svh"
`include "register_interface/assign.svh"

`ifndef FPGA_EMUL
  `ifndef SIMPLE_PADFRAME
      `include "alsaqr_periph_padframe/assign.svh"
    `else
      `include "alsaqr_periph_fpga_padframe/assign.svh"
  `endif
`else
  `include "alsaqr_periph_fpga_padframe/assign.svh"
`endif

`include "axi/typedef.svh"
`include "axi/assign.svh"
`include "cluster_bus_defines.sv"
`include "pulp_soc_defines.sv"

module al_saqr
  import axi_pkg::xbar_cfg_t;
  import apb_soc_pkg::NUM_GPIO;
  import udma_subsystem_pkg::*;
  import gpio_pkg::*;
  import ariane_soc::*;

  `ifndef FPGA_EMUL
    `ifndef SIMPLE_PADFRAME
        import pkg_alsaqr_periph_padframe::*;
      `else
        import pkg_alsaqr_periph_fpga_padframe::*;
      `endif
  `else
      import pkg_alsaqr_periph_fpga_padframe::*;
  `endif

  import ariane_soc::HyperbusNumPhys;
  import ariane_soc::NumChipsPerHyperbus;
#(
  parameter int unsigned AXI_USER_WIDTH    = ariane_axi_soc::UserWidth,
  parameter int unsigned AXI_ADDRESS_WIDTH = 64,
  parameter int unsigned AXI_DATA_WIDTH    = 64,
`ifdef DROMAJO
  parameter bit          InclSimDTM        = 1'b0,
`else
  parameter bit          InclSimDTM        = 1'b1,
`endif
  parameter int unsigned NUM_WORDS         = 2**25,         // memory size
  parameter bit          StallRandomOutput = 1'b0,
  parameter bit          StallRandomInput  = 1'b0,
  parameter bit          JtagEnable        = 1'b1
) (
  inout logic         rtc_i,
  inout logic         rst_ni,
  inout logic         bypass_clk_i,

`ifdef XILINX_DDR
  AXI_BUS.Master      axi_ddr_master,
`endif

  // HYPERBUS
  `ifndef XILINX_DDR
  inout  [HyperbusNumPhys-1:0][NumChipsPerHyperbus-1:0] pad_hyper_csn,
  inout  [HyperbusNumPhys-1:0]                          pad_hyper_ck,
  inout  [HyperbusNumPhys-1:0]                          pad_hyper_ckn,
  inout  [HyperbusNumPhys-1:0]                          pad_hyper_rwds,
  inout  [HyperbusNumPhys-1:0]                          pad_hyper_reset,
  inout  [HyperbusNumPhys-1:0][7:0]                     pad_hyper_dq,
  `endif

 `ifndef EXCLUDE_PADFRAME
  inout wire logic    pad_periphs_a_00_pad,
  inout wire logic    pad_periphs_a_01_pad,
  inout wire logic    pad_periphs_a_02_pad,
  inout wire logic    pad_periphs_a_03_pad,
  inout wire logic    pad_periphs_a_04_pad,
  inout wire logic    pad_periphs_a_05_pad,
  inout wire logic    pad_periphs_a_06_pad,
  inout wire logic    pad_periphs_a_07_pad,
  inout wire logic    pad_periphs_a_08_pad,
  inout wire logic    pad_periphs_a_09_pad,
  inout wire logic    pad_periphs_a_10_pad,
  inout wire logic    pad_periphs_a_11_pad,
  inout wire logic    pad_periphs_a_12_pad,
  inout wire logic    pad_periphs_a_13_pad,
  inout wire logic    pad_periphs_a_14_pad,
  inout wire logic    pad_periphs_a_15_pad,
  inout wire logic    pad_periphs_a_16_pad,

  `ifndef FPGA_EMUL
    `ifndef SIMPLE_PADFRAME
        inout wire logic    pad_periphs_a_17_pad,
        inout wire logic    pad_periphs_a_18_pad,
        inout wire logic    pad_periphs_a_19_pad,
        inout wire logic    pad_periphs_a_20_pad,
        inout wire logic    pad_periphs_a_21_pad,
        inout wire logic    pad_periphs_a_22_pad,
        inout wire logic    pad_periphs_a_23_pad,
        inout wire logic    pad_periphs_a_24_pad,
        inout wire logic    pad_periphs_a_25_pad,
        inout wire logic    pad_periphs_a_26_pad,
        inout wire logic    pad_periphs_a_27_pad,
        inout wire logic    pad_periphs_a_28_pad,
        inout wire logic    pad_periphs_a_29_pad,

        inout wire logic    pad_periphs_b_00_pad,
        inout wire logic    pad_periphs_b_01_pad,
        inout wire logic    pad_periphs_b_02_pad,
        inout wire logic    pad_periphs_b_03_pad,
        inout wire logic    pad_periphs_b_04_pad,
        inout wire logic    pad_periphs_b_05_pad,
        inout wire logic    pad_periphs_b_06_pad,
        inout wire logic    pad_periphs_b_07_pad,
        inout wire logic    pad_periphs_b_08_pad,
        inout wire logic    pad_periphs_b_09_pad,
        inout wire logic    pad_periphs_b_10_pad,
        inout wire logic    pad_periphs_b_11_pad,
        inout wire logic    pad_periphs_b_12_pad,
        inout wire logic    pad_periphs_b_13_pad,
        inout wire logic    pad_periphs_b_14_pad,
        inout wire logic    pad_periphs_b_15_pad,
        inout wire logic    pad_periphs_b_16_pad,
        inout wire logic    pad_periphs_b_17_pad,
        inout wire logic    pad_periphs_b_18_pad,
        inout wire logic    pad_periphs_b_19_pad,
        inout wire logic    pad_periphs_b_20_pad,
        inout wire logic    pad_periphs_b_21_pad,
        inout wire logic    pad_periphs_b_22_pad,
        inout wire logic    pad_periphs_b_23_pad,
        inout wire logic    pad_periphs_b_24_pad,
        inout wire logic    pad_periphs_b_25_pad,
        inout wire logic    pad_periphs_b_26_pad,
        inout wire logic    pad_periphs_b_27_pad,
        inout wire logic    pad_periphs_b_28_pad,
        inout wire logic    pad_periphs_b_29_pad,
        inout wire logic    pad_periphs_b_30_pad,
        inout wire logic    pad_periphs_b_31_pad,
        inout wire logic    pad_periphs_b_32_pad,
        inout wire logic    pad_periphs_b_33_pad,
        inout wire logic    pad_periphs_b_34_pad,
        inout wire logic    pad_periphs_b_35_pad,
        inout wire logic    pad_periphs_b_36_pad,
        inout wire logic    pad_periphs_b_37_pad,
        inout wire logic    pad_periphs_b_38_pad,
        inout wire logic    pad_periphs_b_39_pad,
        inout wire logic    pad_periphs_b_40_pad,
        inout wire logic    pad_periphs_b_41_pad,
        inout wire logic    pad_periphs_b_42_pad,
        inout wire logic    pad_periphs_b_43_pad,
        inout wire logic    pad_periphs_b_44_pad,
        inout wire logic    pad_periphs_b_45_pad,
        inout wire logic    pad_periphs_b_46_pad,
        inout wire logic    pad_periphs_b_47_pad,

        inout wire logic    pad_periphs_ot_spi_00_pad,
        inout wire logic    pad_periphs_ot_spi_01_pad,
        inout wire logic    pad_periphs_ot_spi_02_pad,
        inout wire logic    pad_periphs_ot_spi_03_pad,
      `endif
    `endif
 `else /* `ifndef EXCLUDE_PADFRAME */
   input  logic fpga_pad_uart_rx_i,
   output logic fpga_pad_uart_tx_o,
 `endif

 `ifdef ETH2FMC_NO_PADFRAME
  input  logic       clk_125MHz,
  input  logic       clk_125MHz90,
  input  logic       clk_200MHz,
  output wire        eth_rstn,
  input  wire        eth_rxck,
  input  wire        eth_rxctl,
  input  wire  [3:0] eth_rxd,
  output wire        eth_txck,
  output wire        eth_txctl,
  output wire  [3:0] eth_txd,
  inout  wire        eth_mdio,
  output wire        eth_mdc,
 `endif

  // JTAG
  inout wire          jtag_TCK,
  inout wire          jtag_TMS,
  inout wire          jtag_TDI,
  inout wire          jtag_TRSTn,
  inout wire          jtag_TDO_data,

  inout wire          jtag_ot_TCK,
  inout wire          jtag_ot_TMS,
  inout wire          jtag_ot_TDI,
  inout wire          jtag_ot_TRSTn,
  inout wire          jtag_ot_TDO_data,
  // Boot Select
  inout wire          pad_bootmode
);
  import lc_ctrl_pkg::*;
  import edn_pkg::*;
  import top_earlgrey_pkg::*;

  localparam int unsigned AsyncAxiOutAwWidth    = secure_subsystem_synth_astral_pkg::SynthAsyncAxiOutAwWidth;
  localparam int unsigned AsyncAxiOutWWidth     = secure_subsystem_synth_astral_pkg::SynthAsyncAxiOutWWidth;
  localparam int unsigned AsyncAxiOutBWidth     = secure_subsystem_synth_astral_pkg::SynthAsyncAxiOutBWidth;
  localparam int unsigned AsyncAxiOutArWidth    = secure_subsystem_synth_astral_pkg::SynthAsyncAxiOutArWidth;
  localparam int unsigned AsyncAxiOutRWidth     = secure_subsystem_synth_astral_pkg::SynthAsyncAxiOutRWidth;
  localparam int unsigned LogDepth              = secure_subsystem_synth_astral_pkg::SynthLogDepth;

  localparam type         axi_secd_aw_chan_t     = secure_subsystem_synth_astral_pkg::synth_axi_remap_out_aw_chan_t;
  localparam type         axi_secd_w_chan_t      = secure_subsystem_synth_astral_pkg::synth_axi_remap_out_w_chan_t;
  localparam type         axi_secd_b_chan_t      = secure_subsystem_synth_astral_pkg::synth_axi_remap_out_b_chan_t;
  localparam type         axi_secd_ar_chan_t     = secure_subsystem_synth_astral_pkg::synth_axi_remap_out_ar_chan_t;
  localparam type         axi_secd_r_chan_t      = secure_subsystem_synth_astral_pkg::synth_axi_remap_out_r_chan_t;
  localparam type         axi_secd_req_t         = secure_subsystem_synth_astral_pkg::synth_axi_remap_out_req_t;
  localparam type         axi_secd_resp_t        = secure_subsystem_synth_astral_pkg::synth_axi_remap_out_resp_t;

  // AXILITE parameters
  localparam int unsigned AXI_LITE_AW       = 32;
  localparam int unsigned AXI_LITE_DW       = 32;

  logic                        s_rst_ni;
  logic                        s_jtag_TCK;
  logic                        s_jtag_TDI;
  logic                        s_jtag_TDO;
  logic                        s_jtag_TMS;
  logic                        s_jtag_TRSTn;
  logic                        s_rtc_i;
  logic                        s_bypass_clk;
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
