AlSaqr-platform/he-soc/(commit log)

2021-09-08 [cluster] Matrix mul on the cluster.
    * the dm_top now can reset the whole chip (cluster as well)
    as specified by riscv
    * using ssh clone for pulp_cluster to ease modifications
    * added support to load the binary for the cluster in tb
    * tcdm banks cannot be reset now
    * test v0 to launch the cluster
    [al_saqr.sv, alsaqr_clk_rst_gen.sv, ariane_tb.sv, host_domain.sv, l2_subsystem.sv]
2021-09-08 [cluster] hello world from ri5cy number 0.
    * add pulp folder in test as a place holder of cluster's code
    * update launch_cluster.c to wait the cluster to finish
    * link the cluster's elf to the tb
    * move uart so that the cluster can access
2021-09-10 [sw] parallelize cluster code
    * modify crt.s to handle more threads
    * patch soc - cluster handshake v0
    * make every core print
2021-09-15 [cluster, sym] load cluster's code through Ariane.
    Added the script to generate a C header to CVA6 core to have ariane
    loading the RI5CY core. Reasons to do so:
    * we have just one elf file, more practical for jtag boot in fpga
    * re-inserted the reset signals in the l2 memory
    Added readme
    [l2_subsystem.sv]
2021-09-20 [fpga] Re-align fpga synth-flow.
    Looks like `not(synthesys)` automatically overrides the `fpga` target.
    To have the xilinx-specific cells linked by Bender to Vivado, we need
    to modify synthesis into `asic`. Distinguish asic and fpga targets!
2021-09-20 [fpga] Adding support vcu118 board.
2021-09-22 [linux,fpga] align device-tree to the actual system. intf patch.
    * align device tree to actual system's features
    * modify boot rom accordingly
    * insert missing pulp_interfaces
    [boot_rom.sv, bootrom.sv, main.c]
2021-09-23 [fpga] Implement an actual ROM. Update ROM code.
    The previous ROM implementation was not properly working. We can
    instantiate an actual ROM, selecting the correct memory type. Update
    the code to not get stuck in phase zero.
    [boot_rom.sv, bootrom.sv, main.c, uart.h]
2021-09-27 [rom] Add generate .sv script. Align uart drivers.
2021-09-27 [scripts] Fix typo in gen_rom_sv.py
    [gen_rom_sv.py]
2021-10-11 [Bender,fpga] Re-align fpga flow. Update Bender.
2021-11-03 [synth] Fixes for synth.
    - Fix width mismatches.
    - Implement cache with macros
    - Upgrade common cells dep for ariane.
    [apb_subsystem.sv, cva6_subsystem.sv, udma_subsystem.sv]
2021-11-08 [test] Add uart config
2021-11-09 fix cs neg and address pointer for TX comman
    [al_saqr.sv, pad_frame.sv, spim.c]
2021-11-09 fix spi test
2021-11-09 fixed SPI test
2021-11-09 fix i2c test
2021-11-09 fix comment on PR
    [ariane_tb.sv, memory_map.h, properties.h]
2021-11-09 add vip camera
2021-11-09 add i2c.c test
2021-11-09 minor fix on ARCHI_HYAXICFG1_ADDR
    [memory_map.h]
2021-11-09 test camera interface
2021-11-09 add frame.h
2021-11-09 enable camera vip trought gpio 0
2021-11-09 add padframe drivers
2021-11-09 fix oen to uart_rx
2021-11-09 add udma uart lib
2021-11-09 add udma uart test
2021-11-09 [padframe] Insert uart in padframe. Inc padframe.c only when needed.
2021-11-09 [sw] Re-align padframe drivers.
2021-11-12 minor fix on addressing peripherals
    [cam.c, gpios.c, timer.h, uart.c]
2021-11-12 minnor fix address length
    [ariane_soc_pkg.sv]
2021-11-19 minor fix on udma address pointer
    [memory_map.h, udma.h]
2021-11-30 Add apb_soc_control. Improve bitstream generation and cluster tests.
    * Add apb_soc_control. Memory mapped registers to drive control
    signals. Easy to extend using reggen.
    * Fix scripts for vcu118.
    * Improve compilation for cluster's tests.
    [al_saqr.sv, alsaqr_xilinx.sv, apb_soc_pkg.sv, apb_subsystem.sv, ariane_soc_pkg.sv]
2021-11-30 Update README and insert setup.sh for cluster.
2021-11-30 Here is the new hyperbus. Two phys managed by one front-end!
    * The new hyperbus provides 2 PHYs interfaces with just 1 AXI and 1 udma
    front-end. `N_HYPER` is now equal to 1, not actually a parameter.
    * Pad frame clean up.
2021-12-08 Fix udma_events width and add dma_evt from cluster to plic.
    [al_saqr.sv, apb_subsystem.sv, ariane_peripherals.sv, ariane_tb.sv, cva6_subsystem.sv, host_domain.sv, udma_subsystem.sv]
2021-12-08 Insert PRELOAD option. Update .c tests for new FLL. JTAG 15MHz.
2021-12-10 Fixed B response errored warning in cluster hello world
    [al_saqr.sv, utils.h]
2021-12-10 H2C TLB correctly configured
    [al_saqr.sv, utils.h]
2021-12-10 Modified tlb config with correct memory base address.
    [utils.h]
2021-12-15 fix APB_BUS and uart for printf
    [apb_subsystem.sv, periph_bus_wrap.sv]
2021-12-23 Jump to cluster with correct default values.
    [al_saqr.sv]
2022-01-21 Fixed reset issue in axi_dw_converter, changed axi2axi_lite datawidth, added tlb regression.
    [al_saqr.sv, ariane_soc_pkg.sv, encoding.h, host_domain.sv, utils.h]
2022-01-25 Properly connect reset for clk_mngr and cva6 clock.
    [alsaqr_clk_rst_gen.sv, alsaqr_xilinx.sv, fpga_clk_gen.sv]
2022-01-25 Use correct clock for axi ddr interface.
    [alsaqr_xilinx.sv, axi_flat.sv]
2022-01-25 Increase freq to 30MHz and fix rtc_i for CLINT.
    The CLINT uses the `rtc_i` to increase its counter. The `rtc_i` is
    filtered with an edge synchronizer. Hence, it has to be at least twice
    slower than the `soc_clk`. Otherwise, the `increment` signal is
    filtered out.
    [cva6_subsystem.sv]
2022-01-25 Several minor fix. See above.
    * Fix DTS. freq and uart (opensbi) compatibile drivers
    * Simplify main.c
    * Modify riscv_amo burst type from fixed to incr (you never know)
    * Increase freq from 30 to 50 MHz
    * Add define to exclude cluster from bitstream -> huge speed-up
    * Remapped uart interrupt
    [al_saqr.sv, alsaqr_clk_rst_gen.sv, ariane_peripherals.sv, main.c]
2022-02-01 Added DMA tests, modified Bender to point at master brances of pulp_cluster and fpu_interconnect
2022-02-01 Clean up and some fixes.
    [utils.h]
2022-02-01 Added DMA tests to regressions.
2022-02-03 Removed repetitions in c2h dma test
2022-02-03 Removed repetitions in h2c dma test
2022-02-08 Renamed DMA tests.
2022-02-08 Removed define for printf in fpu_test
2022-02-09 Fixed dma test name.
2022-02-20 Corrected cluster clock assign.
    [alsaqr_clk_rst_gen.sv]
2022-02-28 Enable mock uart when tb is target.
2022-02-28 Update to hyperbus macro. Fix regression with localjtag.
    [al_saqr.sv, apb_subsystem.sv, ariane_tb.sv, host_domain.sv, pad_frame.sv, udma_subsystem.sv]
2022-03-01 Point to core with fence.t, new fll and reg_intf. Fix preload.
    [ariane_tb.sv, cva6_subsystem.sv]
2022-03-28 Insert memory mapped registers and gwt_test pads.
2022-03-28 Insert Khalifa dummy dcdc
2022-03-28 Fix ID mismatch for serial link.
    [cva6_subsystem.sv]
2022-03-28 Fix constraints. Post synth simulations, WIP.
    [ariane_tb.sv, pad_frame.sv]
2022-03-28 Cut timing loop between serial link ports.
2022-03-28 Fix serial link ID width. Bump cluster and hyper.
    [cva6_subsystem.sv]
2022-03-28 Bump CVA6 to H-ext 1.0.0 and common pads. Fix ku_cdc pads.
    [pad_frame.sv]
2022-03-30 Add Dhrystone for perf profiling. Fix #flo in mm bench.
    [dhrystone_main.c, mm_main.c]
2022-03-30 Fix Dhrystone printfs and generate also one chip hyperram slm.
    [dhrystone_main.c, elf_to_slm.py]
2022-04-04 Re-align FPGA flow. Remove `axi_cut` between xbar and AXI DDR4.
2022-04-04 Change `jtag_ariane_wakeup` to not use the reset but changing DPC.
    [ariane_tb.sv]
2022-04-12 Add option to switch between HYPERRAM and on chip sram.
2022-05-11 Define `axi_lite_domain`. Insert ATOP between xbar and L2.
2022-05-18 Fix reset for cdc fifos: reset both src and dst simultaneously.
    [al_saqr.sv]
2022-05-30 Remove `h2c_tlb` and correct fpga constraints.
    The `h2c_tlb` is useless: when a requests comes into the cluster
    address range, the hypotethical address translation must have already
    been performed.
    Using a more recent version of Vivado, we do not need to specify the
    constraints on the `STARTUPE3`.
    [al_saqr.sv, axi_lite_subsystem.sv, hello_pulp.c]
2022-05-30 Added second UART for cluster debugging
2022-06-01 Align `xdc` and `alsaqr_xilinx.sv`. Add `idx` to UARTs and define.
    When compiling the cluster code, you can activate the second uart
    by passing CLUSTER_UART=1 to the makefile when compiling.
2022-07-22 From unsigned to signed and fix check.
    [conv_kernel.c, gen_input.c, golden.c, main.c]
2022-07-25 Add `conv_cluster` and fix Makefile optimization flags.
    [conv_kernel.c, gen_input.c, golden.c, main.c, stimuli.c, utils.h]
2022-09-05 modified padframe for FPGA peripheral board testing
2022-09-05 updated with FMC peripheral board pin assignments
2022-09-05 fix peripherals mapping on FMC connector
    [fmc_board_vcu118.xdc, fmc_hyper_board_vcu118.xdc]
2022-09-05 update i2c for FPGA testing
2022-09-05 update xdc for FMC peripheral (i2c-uart-spi-sdio) board
2022-09-05 update xdc for FMC hyper board
2022-09-05 update flag for camera instantiation
2022-09-05 clean i2c test
2022-09-05 minor fix to tb and camera vip
    [ariane_tb.sv, cam_vip.sv]
2022-09-05 minor fix for fpga/rtl execution
    [cam.c, i2c.c, sdio.c, spim.c, uart.c]
2022-09-07 minor fix for i2c
    [ariane_tb.sv, i2c.c]
2022-11-17 Add couple defines for back-end. Add netlist simulation support.
2022-11-17 Add simple memory mapped LLC perf counters' drivers.
2022-11-23 Go back to the working FMC extension board with Hyper :rocket:
    Use the old extension board with just one hyper on FPGA
2022-12-13 minor fix for fpga padframe
    [ariane_tb.sv]
2023-03-27 Moved the software drivers of the padframe into the software directory.
2023-03-28 update padframe drivers
2023-07-06 minor fix and comments clean
    [ariane_tb.sv]
2023-07-27 fix trailing spaces within .sv files
    [al_saqr.sv, alsaqr_clk_rst_gen.sv, alsaqr_xilinx.sv, apb_fll_wrap.sv, apb_soc_control.sv, apb_soc_pkg.sv, apb_subsystem.sv, ariane_axi_soc_pkg.sv]
2023-07-27 add configurable cdc sync stages
2023-07-27 OpenTitan integration.
    - System-level integration of OpenTitan
    - Connected as a master to AXI4 interconnect
    - Interrupt connections for Mailbox
    - In/Out pins for JTAG and Bootselect
    - FPGA synthesis with OpenTitan
    - Extended TB with OpenTitan JTAG tasks
    - Updated bootrom to allow boot from OpenTitan
    - Added scratch constraint for opentitan SPI (waitign for new padframe)
2023-07-28 Updated reference to can_bus
2023-08-02 Fixed the simulations with the gf22 tech memory wrapper.
    [al_saqr.sv, ariane_tb.sv]
2023-08-02 Renamed axi asynch ot signals in top module and exposed sync stages parameter
2023-08-04 fix no preload end of computation
    [ariane_tb.sv]
2023-08-22 Update ariane_axi_soc_pkg.sv
    fixed the axilite strobe bit issue
    [ariane_axi_soc_pkg.sv]
2023-08-30 Fixed error in return and possibility to select core via makefile
    [ariane_tb.sv]
2023-09-13 Fixed GPIO test; Removed some unused signals
    [al_saqr.sv, gpios_all_out.c]
2023-09-14 Fixed xbar configuration for the LLC; fixed the LLC test; improved the l2_test
    [ariane_soc_pkg.sv, axi_llc_reg32.c, axi_llc_regs.h, cva6_subsystem.sv, utils.h]
2023-09-14 Added the default values to the registers controlling LLC address spaces
    Removed whitespace
    Fixed an error
    [cva6_subsystem.sv]
2023-09-15 fix width mismatch on llc
    [host_domain.sv]
2023-09-26 Updated test initialization to avoid uninitialized value propagation; Updated C drivers of the LLC
    [axi_llc_reg32.c, axi_llc_regs.h]
2023-09-27 Updated LLC's address map input variable sizes; Improved the tests with 2 reads/writes to avoid uninitialized data
    [host_domain.sv]
2023-09-27 Fixed the LLC's address map
    [host_domain.sv]
2023-10-09 add parameter for synthesis and fix fpga clock for opentitan
    [alsaqr_clk_rst_gen.sv]
2023-10-10 update pwm api and test for 8 pwm timers
2023-10-10 attach pwm interrupts to plic
2023-10-10 Integrating new padframe.
    Removed the apb_uart for cluster (not anymore in the specs)
    Moved CVA6 apb uart to padrick
    Adapted top module to new padframe
2023-10-11 attach channel 1 to PWMs to be used as alternate functions
2023-10-11 update pwm test & api to program PWMs
2023-10-16 Fixing l2 instantiation in synthesis & updating macro sim scripts
    [l2_subsystem.sv, l3_onchip_subsystem.sv]
2023-10-18 add local resetgen with output clock
    [rstgen_bypass_ckg.sv, rstgen_ckg.sv]
2023-10-21 Add FLL driver support
2023-10-25 Fix FLL driver define in Makefile
2023-10-26 unroll pwm assignments
2023-10-26 remove unused channel 0 output from PWMs
2023-10-26 update pwm test
2023-10-26 Integrate tests into regression flow
2023-10-26 avoid instantiation of cluster uart in gf22 synthesis
    [apb_subsystem.sv, ariane_peripherals.sv]
2023-10-26 Fixed some issues with the TB
    [ariane_tb.sv]
2023-10-26 Added command to simulate in debug mode allowing schematic view
2023-10-26 Updated UART test for the new padframe
2023-10-26 Updated CAM test for the new padframe; Fixed CAM VIP image path
    [cam.c, cam_vip.sv]
2023-10-26 Updated I2C test for the new padframe
2023-10-26 Updated SPI test for the new padframe
2023-10-26 Updated QSPI test for the new padframe; Fixed TB error that prevented test from executing
    [ariane_tb.sv, qspim.c]
2023-10-26 Developing sw environment for dual core execution.
    - Modified bootrom to managed the irqs for both the cores accordin to
    core-id
    - Created tests to run in dual core (multithreading)
    - Added a clock mux to opentitan clock in order to choose the ref
    clock
    - Now possible to boot both the cores from jtag (independen boot);
    chain boot, JTAG boots core 0 which will boot core 1; boot
    - Supporting chain boot from irq (by OT), not yet independent boot.
    - Ported Culsans sw environment and tests in alsaqr repo
2023-10-26 Fixing second core boot with localjtag
    [ariane_tb.sv]
2023-10-26 Fixed tb and byp test, now working ok.
    [ariane_tb.sv]
2023-11-03 Update `README.md` to add cluster execution flow
2023-11-08 Added missing alt_0 signal prefixes
    [ariane_tb.sv]
2023-11-08 Applying fixes to run on new lagrev OS
    [ariane_tb.sv]
2023-11-08 Reducing size of bootrom.h and fix defines
    [ariane_tb.sv]
2023-11-08 Fixing tb to allow automation of tests and created regression script
    [regression.csv]
2023-11-08 Updating timeout and removing wrong test from regresson
    [regression.csv]
2023-11-09 Updating boot rom to fix irq issues.
    [bootrom.sv, main.c]
2023-11-09 Fixing typos on tb after rebase, remove prleoad flag as is now the default
    [ariane_tb.sv, regression.py]
2023-11-09 Fixing JTAG process indenting
    [ariane_tb.sv]
2023-11-13 Updates to regression tests and scripts.
    - Updated the linker L2 mem size, wasn't aligned to actual L2 size.
    - Updated spi and qspi tests as they was accessing a region of L2
    which does not exists anymore
    - Created a make target to run the new regression scripts on the full
    chip netlist
    - Adding to RTL regressions also the tests in the old one.
    - Updating README
    - Exploiting check-regs.sh also in new regressions.
    [regression.csv, regression_netlist.csv]
2023-11-13 fixed typo in regression script.
    [regression.csv, regression_netlist.csv]
2023-11-13 Moving regressions scripts to dedicated folder
    [regression_netlist.csv]
2023-11-14 Updating fpga padframe with opentitan SPI.
2023-11-14 Updating padframe for FPGA with Cva6 uart.
2023-11-14 Fix bug of not found bootrom.h
    [sim_spike.cc]
2023-11-14 Fixing typos in constaints. Moving OT xdc in other file.
    [fmc_board_vcu118.xdc]
2023-11-14 Adding mux select to enable UART for debug.
2023-11-14 Add set_property CLOCK_DEDICATED_ROUTE FALSE to Ot rstgen clk_muxes as are actually used by resets
    [constraints_opentitan.xdc]
2023-11-21 Bumping axi riscv atomics: fix llc performance bug.
    [cva6_subsystem.sv]
2023-11-21 Fixes to ethernet integrations
    [apb_subsystem.sv, ariane_peripherals.sv, ariane_tb.sv, cva6_subsystem.sv, host_domain.sv]
2023-11-22 Fix `warning: cast to pointer from integer of different size`
    [llc.c]
2023-11-28 Updating FPGA README with instructions to use OpenTitan. Adding openocd config files and images showing JTAGs connnections
    [ariane.cfg, ibex.cfg]
2023-11-28 Add support for the double HyperBUS PHY FMC board on FPGA
2023-11-28 [FPGA] Explicitly instantiate UART pads
2023-12-06 Restoring correct eth connections
    [ariane_peripherals.sv]
2023-12-09 Removed build_single, introduced uart receiver to see prints from netlist
2023-12-14 Pointing to hyperbus_udma with bug fix.
    Updating also tests with functions to setuop the uart pad
    Updating scripts for regressions with post synthesis netlist
    [regression.csv, regression_netlist.csv]
2023-12-15 Pointing now to master branch for hyperbus, fix is merged. Updated regression list for netlist with cluster's tests
    [regression_netlist.csv]
2023-12-15 Updating pulp cluster tests to config the uart pads. Now showing the prints on the terminal as well
2023-12-19 nano fix fll dummy
    [fll_dummy.sv]
2023-12-19 Moving uart pads outside exclude-padframe def.
    Now the prints are shown on questasim terminal also with the apb
    uart (for post synth simulations).
    [regression_netlist.csv]
2024-01-16 Moved set_fll and uart_config to runtime, run only by core 0 before booting core 1.
2024-01-16 Fix wrong assignment, giving issues with recent versions of Vivado
    [cva6_synth_wrap.sv]
2024-01-17 sw: fix regression flow for pulp-cluster test
    [regression.csv, regression_netlist.csv]
2024-01-18 temporary remove L1 test
    [regression_netlist.csv]
2024-01-18 fix uart sync with uart_wait function
2024-01-19 Fix runtime and tests to match the latest HW changes
    [stimuli.c]
2024-01-19 Update regression framework for cluster tests
    [regression.csv, regression_netlist.csv]
2024-01-31 [FPGA]: Fix N30 IOSTANDARD LVCMOS12 FPGA pin config
    [fmc_board_opentitan_vcu118.xdc]
2024-01-31 Rework the simulation flow to streamline it
2024-01-31 Update flow to generate the final litmus tests directly
2024-02-02 Adding openocd config file for dual core conf & updated README
    [dual_core_ariane.cfg]
2024-02-28 Improve test simulation flow * Better handling of make parallel execution * Add profiling commands
2024-02-28 Rework the bare metal Culsans perf tests * Add cache warming * Use inline assembly in profiled sections * Use MHPM counters to extract metrics
    [main.c]
2024-05-14 adding ethernet support for VCU118
    Changes made:
    * `Bender.yml` now uses the latest ethernet IP (mf/eth-alsaqr);
    * Integrated the ethernet IP in `alsaqr_xilinx` using DDR memory;
    * Adjusted the integration of the ethernet IP in `al_saqr` and all relative submodules;
    * Added constraints to map ethernet IP signals to the FMC connector of the
    VCU118;
    * Added constraints for input/output delay of ethernet IP signals;
    * Clock manager IP now generates 300MHz, 125MHz and 125MHz90deg for the
    ethernet IP and relative constraints are added;
    * Use 300MHz instead of 200MHz as `REFCLK` for the `IDELAYCTRL` IP inside ethernet
    IP;
    * When using ethernet IP the soc clock is set to 50MHz;
    * Upd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
2024-05-31 fpga: fix bitstream generation + ethernet improvement with simple_padframe
    [al_saqr.sv, alsaqr_xilinx.sv, ariane_tb.sv, host_domain.sv]
2024-06-21 Remove Ethernet test from regression list
    [regression.csv]
2024-07-09 Fix typo in `alsaqr_xilinx.sv`
    [alsaqr_xilinx.sv]
2024-07-09 Rework FPGA synth setup flow
    [cva6_subsystem.sv]
2024-07-09 Update `README.md` to include latest changes to the FPGA flow
2024-08-27 Replace `axi2tcdm` with `axi_to_mem_split`
    [axi2tcdm_wrap.sv]
2024-09-04 Minor fix + including eth test into regression list.
    [regression.csv]
2024-09-19 Update regression script to support ethernet IP
    [regression.csv]
2024-09-21 Fix bootrom to exploit new APLIC for IRQ.
    [ariane_tb.sv, bootrom.sv, main.c]
2024-09-21 enchance regression and include minho tests.
    [regression.csv]
2024-09-21 bump iopmp and enhance regression
    [old_regression.csv, regression.csv]
2024-09-21 Remove tests which need to be updated from regressions
    [regression.csv]
2024-09-21 Fix typo from rebase
    [cva6_subsystem.sv]
2024-09-30 Fix top module and FPGA synthesis.
    Not placing the desing yet because the design is too large as of now
    for the VCU118.
    [regression.csv]
2024-09-30 repo cleanup
    [ariane-multi-hart.cfg, ariane-zcu102.cfg, ariane.cfg, ariane_pmod.cfg, ariane_pmod_tiny.cfg, ariane_sim.cfg]
2024-09-30 Finalize design and integration of snooper.
    [regression.csv]
2024-09-30 Various rebase fixes. CVA6 and riscv_nn bump.
    [regression.csv]
2024-09-30 Update snooper architecture and loop fix.
    [regression.csv]
2024-09-30 Include in regresisosn also snooper tests
    [regression.csv]
2024-10-04 Update regression list and bump opentitan.
    [regression.csv]
2024-10-04 fix bugs with snooper and bump CVA6
    [regression.csv]
2024-10-11 Add clk for cluster to opentitan and fix typos
    [al_saqr.sv]
2024-10-17 Adapth id_width also in scritp and top wrapper for xilinx. Fix fpga uart
    [alsaqr_xilinx.sv]
2024-10-23 Add script to extract and comapre traces for snooper test, only instr case
2024-10-25 uart aplic
2024-10-25 reintroduce peripherals tests to regression
    [regression.csv]
2024-10-25 Fix costraints without ethernet. Bump CVA6,
    [cv64a6_imafdch_wb_sv39_alsaqr_pkg.sv, i2c.c]
2024-11-06 Fix DC compiler and bump apmu.
    [cva6_subsystem.sv, host_domain.sv]
2024-11-06 bump hyperbus, llc, extend regression and axi_lite mmap.
    [regression.csv]
2024-11-06 temporary remove usart and i2c tests from list: broken.
    [regression.csv]
2024-11-06 Fix to 4h timout for regressions
    [regression.py]
2024-11-11 Fix directionlity of AXI PMU's interface
    [cva6_subsystem.sv]
2024-11-15 Conncet propely cut's clock
2024-11-15 Remove mdma and its iopmp, remove the test from regression
    [regression.csv]
2024-11-18 Fix regression list's broken test name.
    [regression.csv]
2024-11-19 Connect log lock to correct iopmp instance and irq.
    [ariane_peripherals.sv, cva6_subsystem.sv, host_domain.sv]
2024-11-20 Connect dw converters in axi_lite -> axi as the dw is different.
    [regression.csv]
2024-11-20 MONITOR COUNTERS ENABLE FIX
    [fifo_indexes_output_prioriy_encoder.sv, htm_block.sv, monitor_counters_t_event.sv]
2024-11-20 fix design compiler errors
    [ones_count_status.sv]
2024-11-28 apb gpio interrupt modification
2024-11-28 Fixes and unpdate reg tests list.
    [regression.csv]
2024-12-29 revert modification that broke OpenOCD on snooper DW conv
    [cva6_subsystem.sv]
2025-01-08 Fix snooper connection: DW converter not needed.
    [cva6_subsystem.sv, cva6_synth_wrap.sv]
2025-01-08 Revert "Fix sw build"
    This reverts commit 0ba1b053a8a12795c36f9bf3b91faf85173802ac.
    [aplic.c, aplic.h]
2025-01-10 Restore old PLIC interrupt arch.
2025-01-12 Bump CVA6, include PLIC in Bender.yml and adapt tests to PLIC.
    [regression.csv]
2025-01-12 Further parametrization to switch to APLIC.
2025-01-13 Remove bender update command (to not overwrite the lock).
    [regression.csv]
2025-01-13 Revert eth to AlSaqr 1 status.
    [regression.csv]
2025-01-14 Fix typo from revert of eth and adjust define to exclude it.
    [al_saqr.sv, ariane_tb.sv, cva6_subsystem.sv, host_domain.sv]
2025-01-15 Bumps for minor fixes.
    [regression.csv]
2025-01-15 Using LLC params from araine SOC pkg-bypassed IOPMP-APMU connected correctly connected to AXI interconnect
    [host_domain.sv]
2025-01-15 Configured APLIC & interrupt generated from PMU
2025-01-28 Adding new test to regression list.
    [regression.csv]
2025-01-28 Bump opentitan
    [regression.csv]
2025-02-01 fix snooper's addr counter
    [snooping_engine.sv]
2025-02-01 Connect log locking missing signals
    [apb_subsystem.sv]
2025-02-01 Reintroducing zicfiss test to regression.
    [regression.csv]
2025-02-13 Update test list
    [regression.csv]
2025-02-13 Bug fix on CVA6 and Snooper
    Ported H-ext bug fix form openhw and fixed a timing loop into snooper
    left from last bug fix.
    [regression.csv]
2025-02-14 Fix setup for running regression tests on chip netlist.
    [regression_netlist.csv]
2025-02-16 Reduce to 10MHz fpga frequency by default for now.
    Minor changes on netlist regression scripts.
    [regression_netlist.csv]
2025-03-06 reset to old values jtag frequencies
    [ariane_tb.sv]
2025-03-10 Enhance regression scripts and reduce number of netlists tests.
    [regression_netlist.csv]
2025-03-13 Bump opentitan and extend regression list
    [regression.csv, regression_netlist.csv]
2025-05-04 Fix setup to run test on L2 (to verify it boots withou L3).
    [ariane_tb.sv]
2025-05-06 Update regression tests list (both netlsit and RTL).
    [regression.csv, regression_netlist.csv]
2025-05-26 Revert "Bump `cva6`"
    This reverts commit 761b3abe86dc4990d89d0b8bdc67a6e57cfc2bb2.
    [ariane_soc_pkg.sv, cva6_subsystem.sv, cva6_synth_wrap.sv]
2025-05-26 Revert "Bump `ace`"
    This reverts commit 2a4463821efcfa02daa301ea9d4d58b8439eeca6.
    [cva6_synth_wrap.sv]
2025-05-26 Fix some errors due to revert. Now sim ok.
    [ariane_soc_pkg.sv, cva6_synth_wrap.sv, snooper.sv, snooper_pkg.sv]
2025-05-26 fix regression lists.
    [regression.csv, regression_netlist.csv]
2025-05-27 Add to tests a comment to be print which clearly states test name.
2025-05-27 sw: remove redundant fll and uart baudrate config
2025-05-28 Adjust fpga freq/baud for current default
2025-05-28 Fix typos in tests.
    [regression.csv]
2025-07-13 Updated the SPU & remapper instantiation with id-fix & new remapper respectively
    [cva6_synth_wrap.sv]
2025-07-13 Updated the SPU & LLC instantiation with id-fix
    [host_domain.sv]
2025-07-15 Connect watermark irq to CVA6 and fix bug on opentitan tlul2mem.
    [al_saqr.sv, cva6_subsystem.sv, host_domain.sv]
2025-07-16 Bump dependencies, remove commented code. Regression ok.
    [regression_netlist.csv]
2025-09-01 Regression update, adding facilities to load cluster binary.
    [regression.csv]
